guanglun/openvio_board/Doc/OPENVIO_V1.6_SCH.pdf

C0402 ¹ 2 | FB1 | 100MHz 180R

# SPI3_SSEL SPI3_MISO

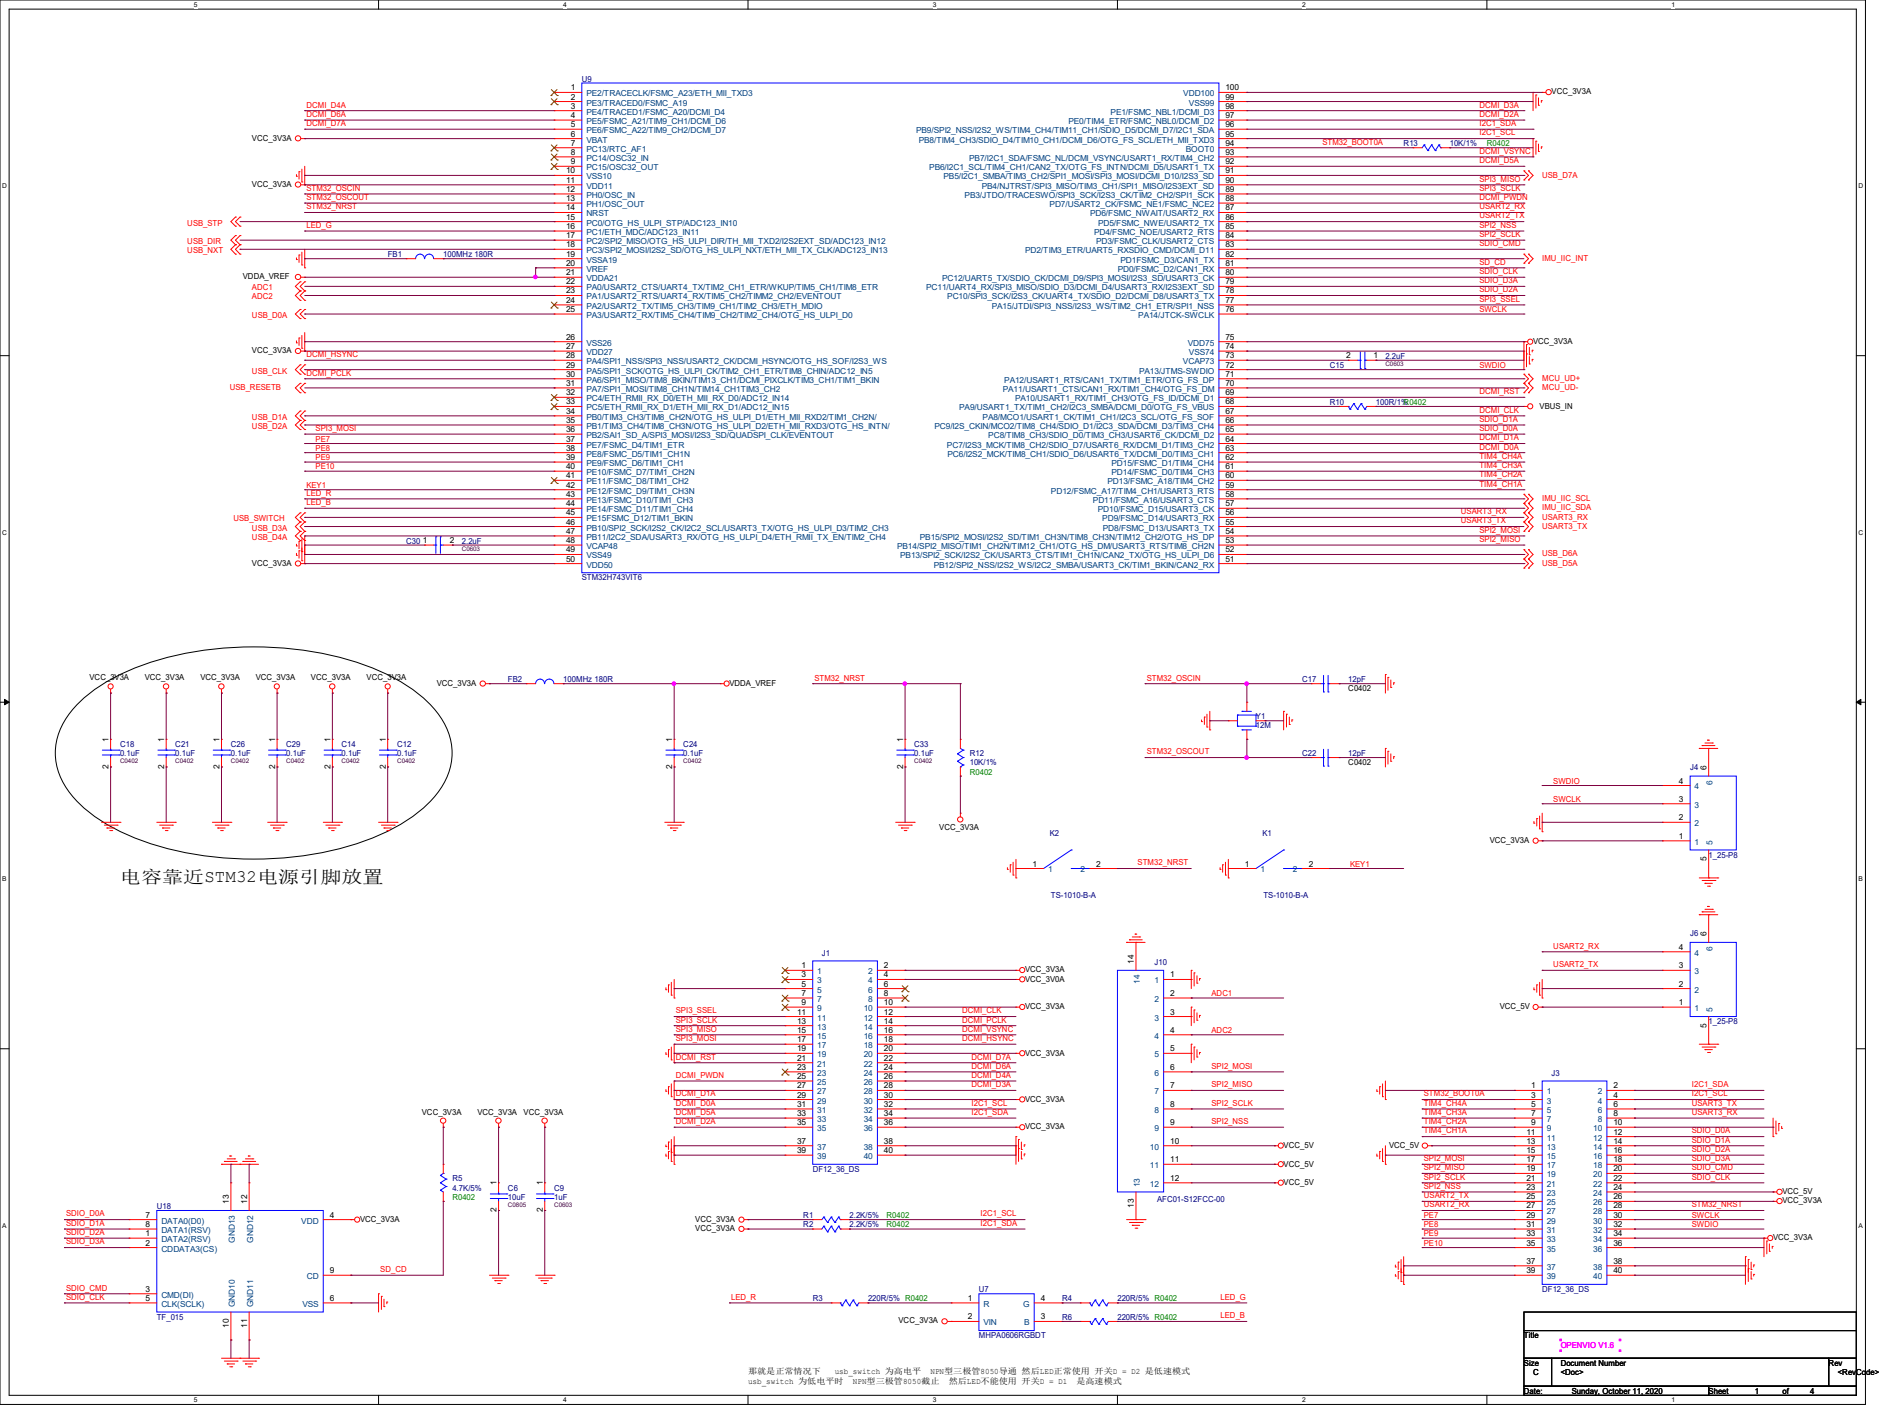
[picture p1: page 1]

A A usb_switch 为低电平时 NPN型三极管8050截止 然后LED不能使用 开关D = D1 是高速模式

供电3V3给MCU | 供电3V3给IMU

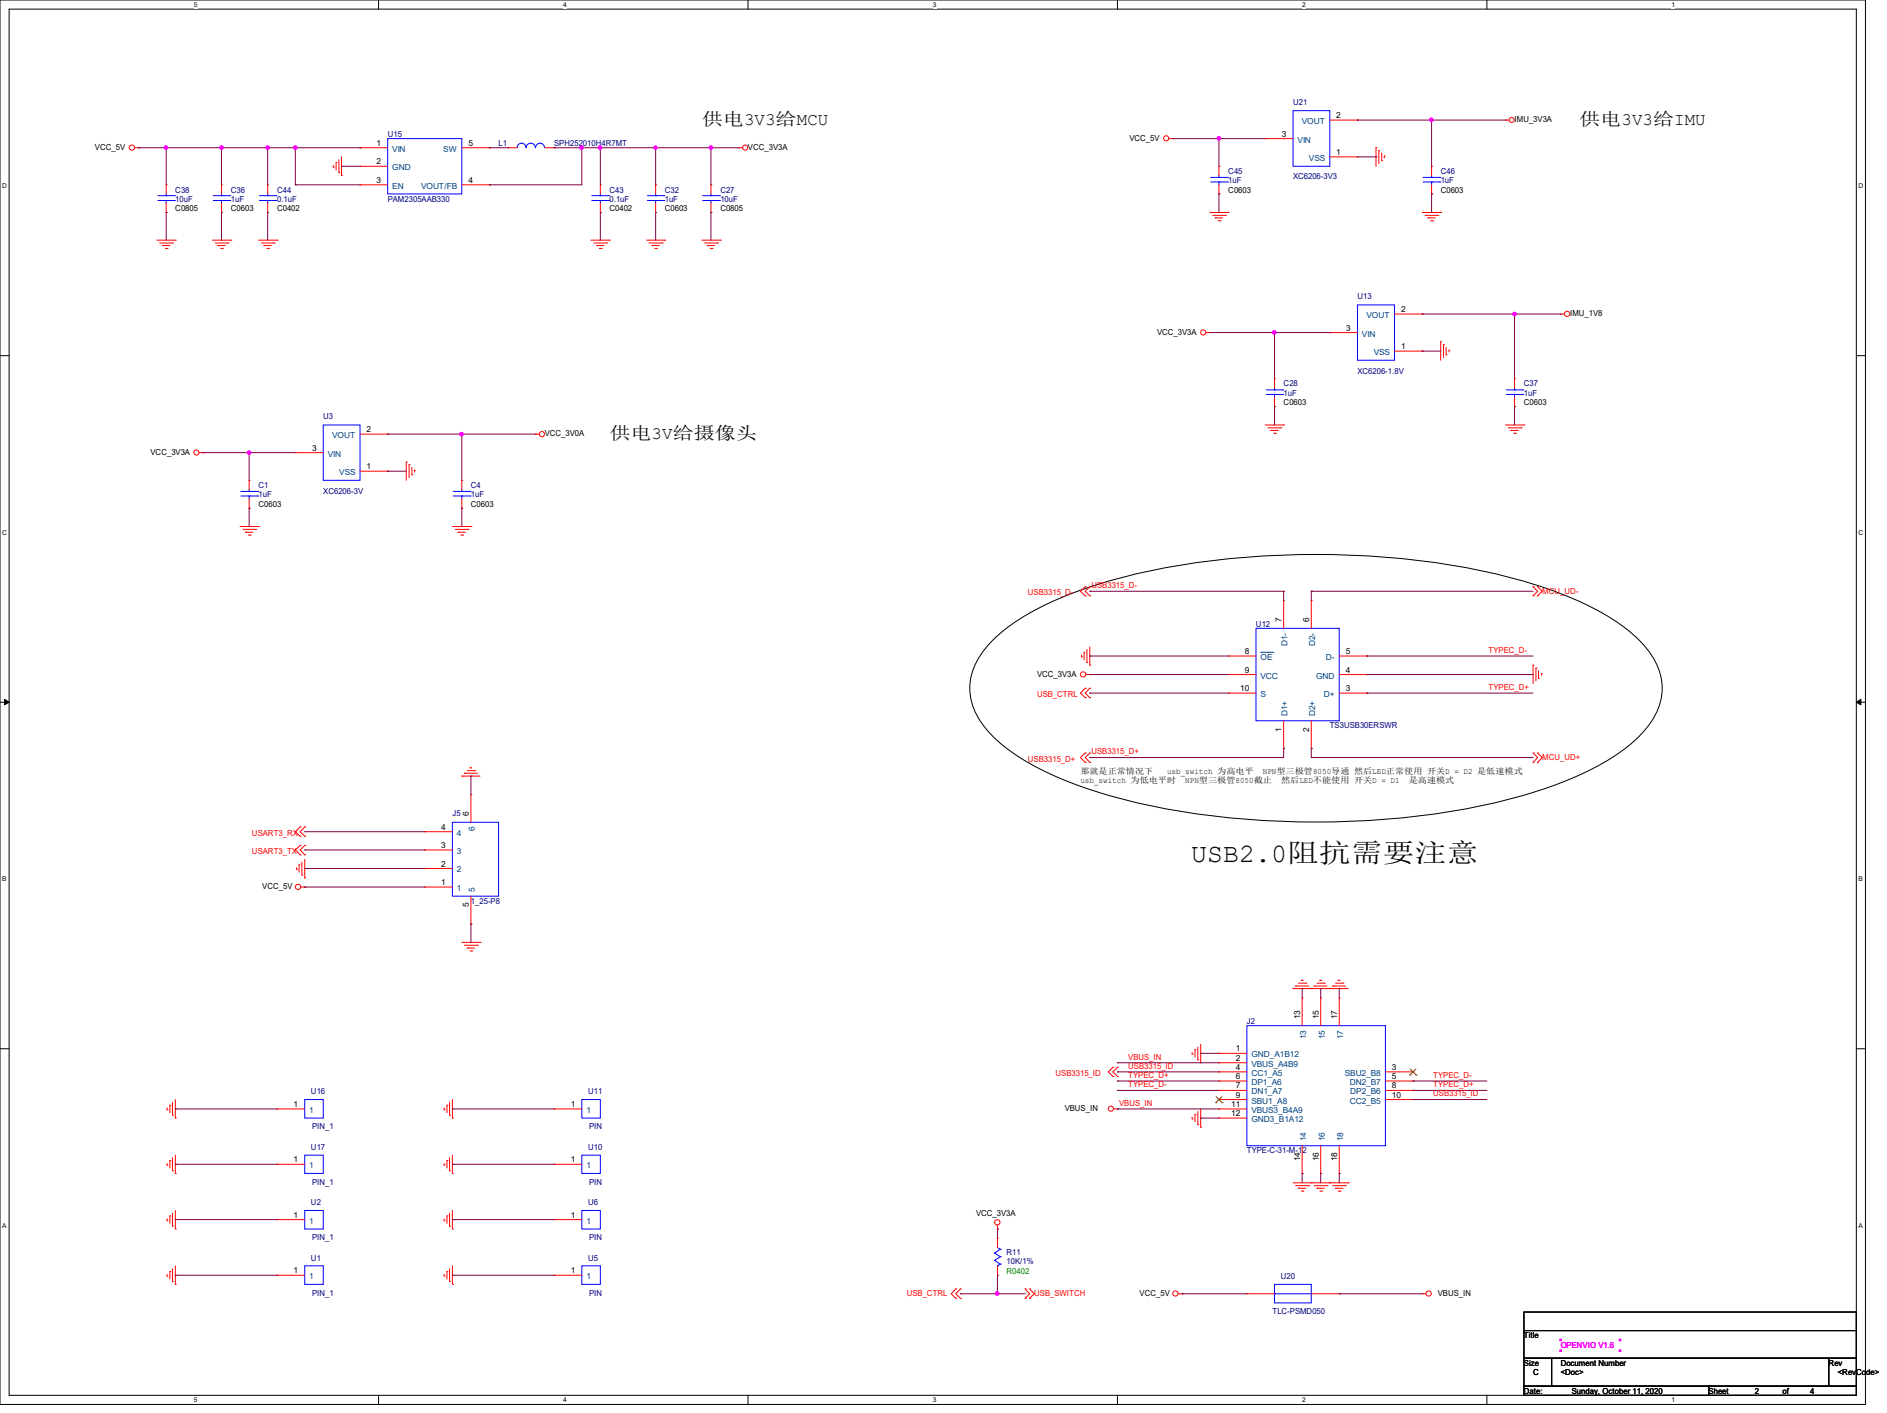
[picture p2: page 2]

usb_switch 为低电平时 NPN型三极管8050截止 然后LED不能使用 开关D = D1 是高速模式

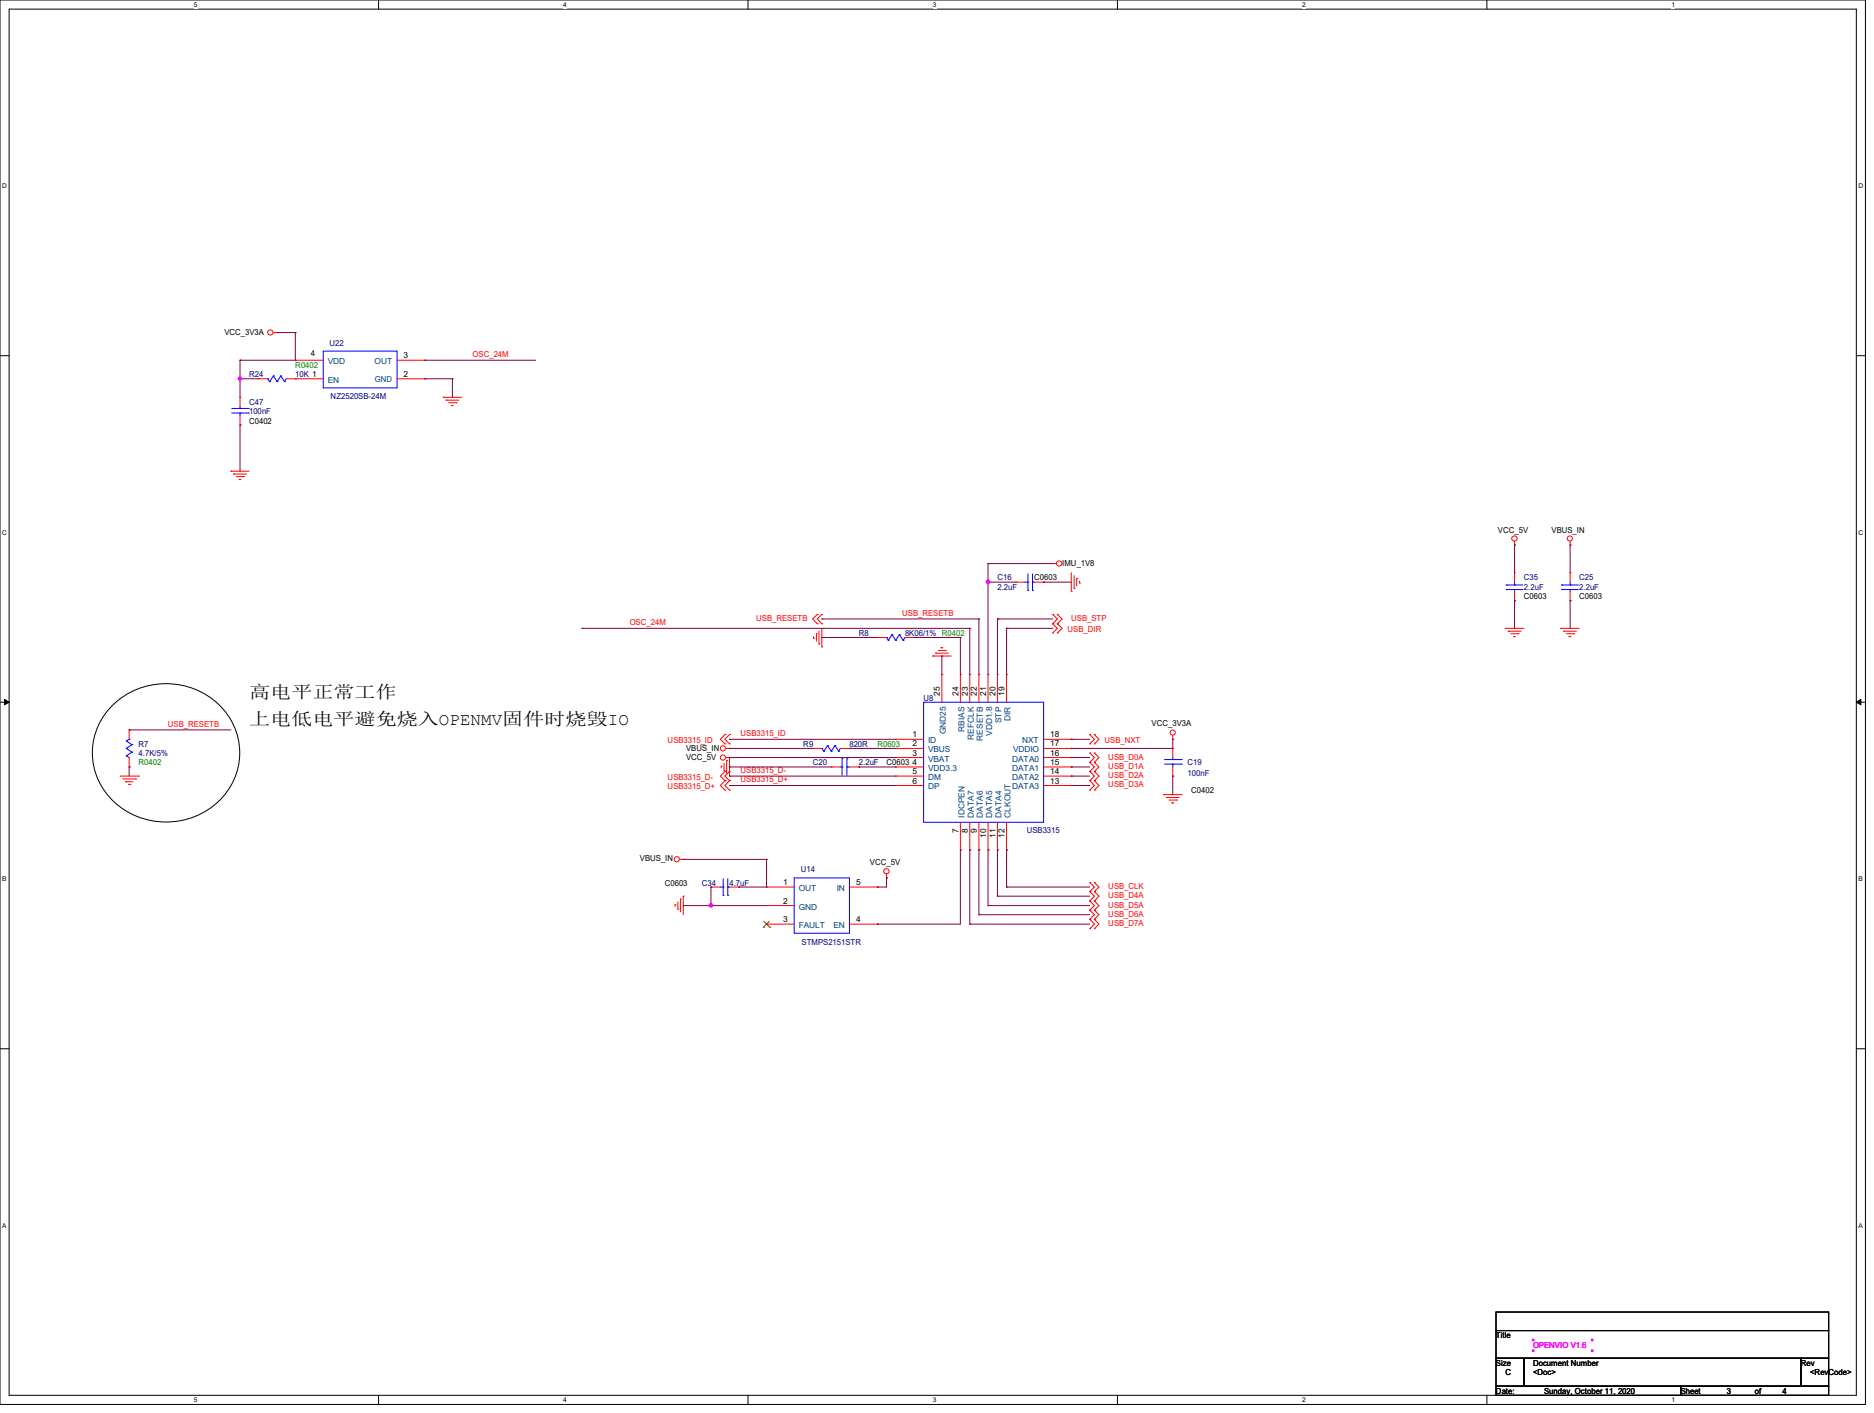
[picture p3: page 3]

9 DATA5 10 DATA4 11 CLKOUT 12 DATA3 13 DATA2 14 DATA1 15 DATA0 16 VDDIO 17 NXT 18 DIR 19 STP 20 VDD1.8 21 RESETB 22 REFCLK 23 RBIAS 24 GND25 25 C16

## IMU_3V3A

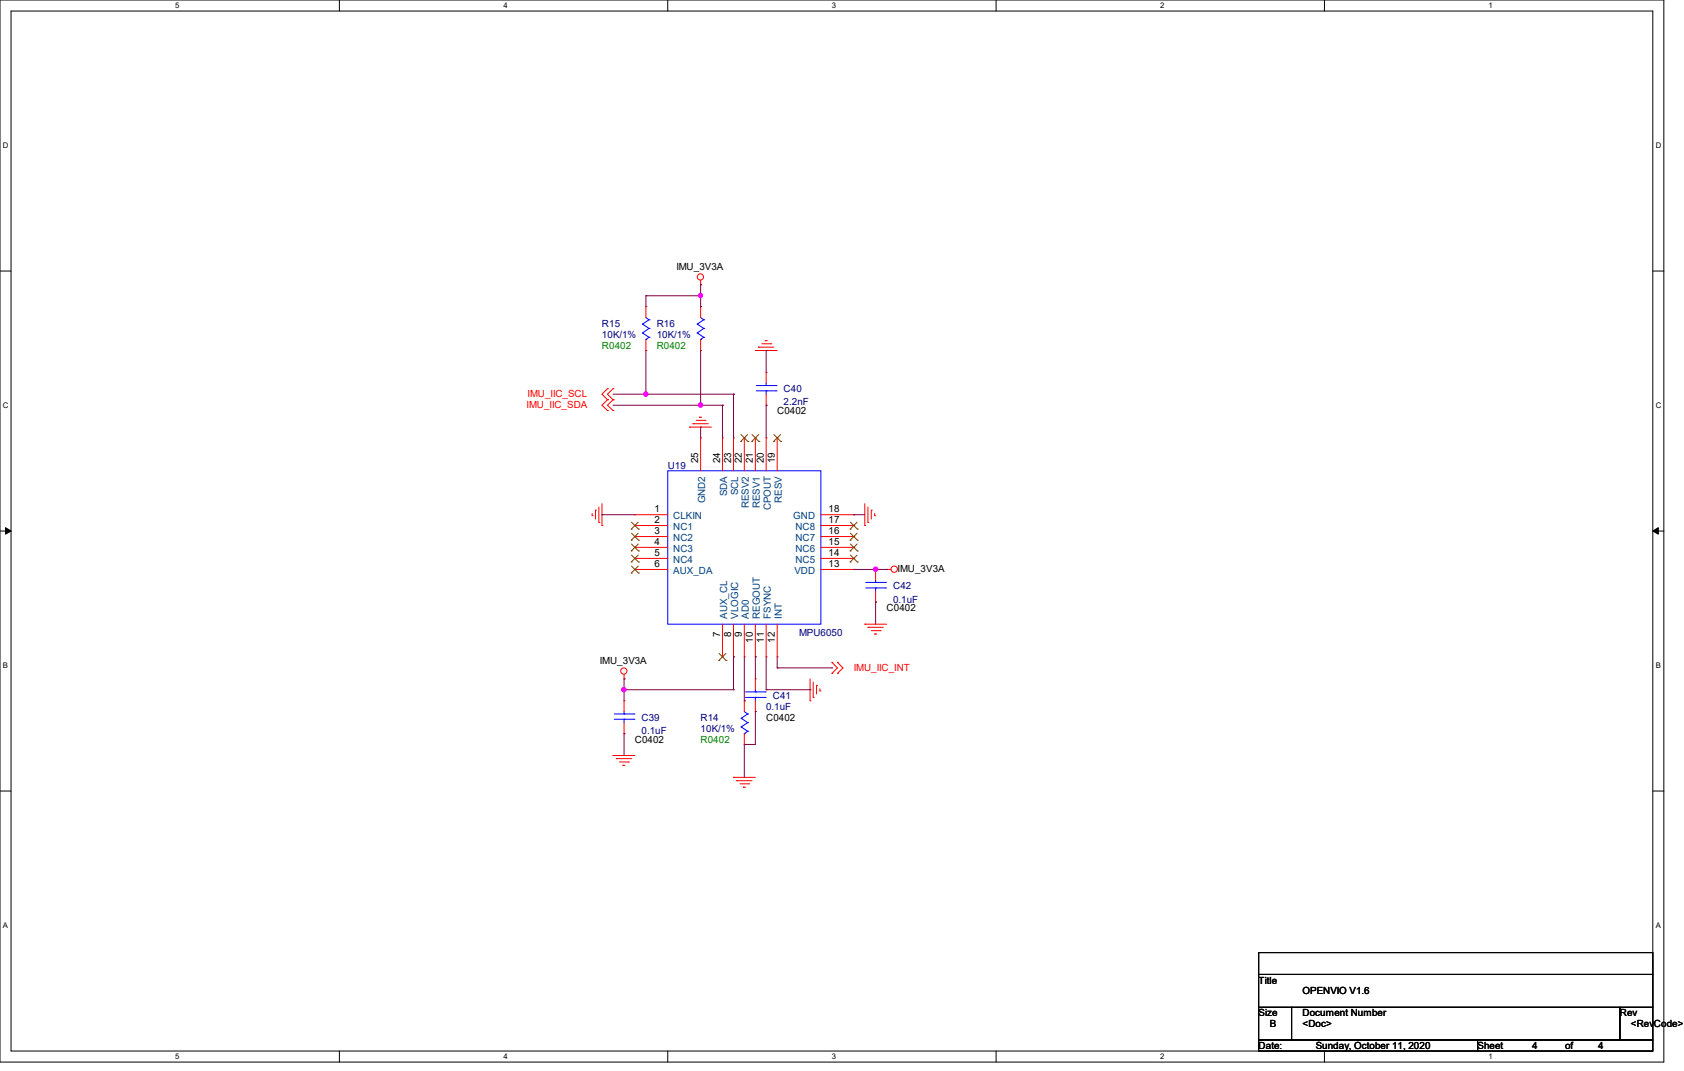
[picture p4: page 4]

9 REGOUT 10 FSYNC 11 INT 12 VDD 13 NC5 14 NC6 15 NC7 16 NC8 17 GND 18 RESV 19 CPOUT 20 RESV1 21 RESV2 22 SCL 23 SDA 24 GND2 25 C42
