guanglun/openvio_board/Src/main.c

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

/* Includes ------------------------------------------------------------------*/
#include "main.h"
#include "cmsis_os.h"
#include "adc.h"
#include "dcmi.h"
#include "dma.h"
#include "fatfs.h"
#include "i2c.h"
#include "mdma.h"
#include "sdmmc.h"
#include "spi.h"
#include "tim.h"
#include "usart.h"
#include "usb_device.h"
#include "gpio.h"


void SystemClock_Config(void);
void MX_FREERTOS_Init(void);
/* USER CODE BEGIN PFP */
uint32_t timer_cnt = 0;
/* USER CODE END PFP */

/**
  * @brief  The application entry point.
  * @retval int
  */
int main(void)
{
  /* Enable I-Cache---------------------------------------------------------*/
  SCB_EnableICache();

  /* MCU Configuration--------------------------------------------------------*/

  /* Reset of all peripherals, Initializes the Flash interface and the Systick. */
  HAL_Init();

  /* Configure the system clock */
  SystemClock_Config();

  /* USER CODE BEGIN SysInit */
  __HAL_RCC_DMA2_CLK_ENABLE();//must enable dma2,for dcmi work well.
  /* USER CODE END SysInit */

  /* Initialize all configured peripherals */
  MX_GPIO_Init();
  MX_DCMI_Init();
  MX_I2C1_Init();
  MX_DMA_Init();
  MX_SDMMC1_SD_Init();
  MX_FATFS_Init();
  MX_SPI2_Init();
  MX_MDMA_Init();
  MX_ADC1_Init();
  MX_USART2_UART_Init();
  MX_TIM6_Init();
  MX_TIM13_Init();
  /* USER CODE BEGIN 2 */
  HAL_TIM_Base_Start_IT(&htim6);
  HAL_TIM_Base_Start_IT(&htim13);
  printf("hello openvio\r\n");

  /* USER CODE END 2 */

  /* Call init function for freertos objects (in freertos.c) */
  MX_FREERTOS_Init(); 
  /* Start scheduler */
  osKernelStart();
 
  /* We should never get here as control is now taken by the scheduler */
  /* Infinite loop */
  /* USER CODE BEGIN WHILE */
  while (1)
  {
    /* USER CODE END WHILE */

    /* USER CODE BEGIN 3 */
      //CDC_Transmit_HS(send_buf,sizeof(send_buf));
  }
  /* USER CODE END 3 */
}

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
/* USER CODE BEGIN 4 */
void get_time(uint32_t *t1_cnt,uint16_t *t2_cnt)
{
	*t2_cnt = htim6.Instance->CNT;
	*t1_cnt = timer_cnt;
}
/* USER CODE END 4 */

 /**
  * @brief  Period elapsed callback in non blocking mode
  * @note   This function is called  when TIM7 interrupt took place, inside
  * HAL_TIM_IRQHandler(). It makes a direct call to HAL_IncTick() to increment
  * a global variable "uwTick" used as application time base.
  * @param  htim : TIM handle
  * @retval None
  */
void HAL_TIM_PeriodElapsedCallback(TIM_HandleTypeDef *htim)
{
  if (htim->Instance == TIM7) {
    HAL_IncTick();
  }
  /* USER CODE BEGIN Callback 1 */
  if (htim->Instance == TIM6) {
	timer_cnt++;
    //HAL_GPIO_TogglePin(TEST1_GPIO_Port, TEST1_Pin);
  }  
  
  if (htim->Instance == TIM13) {
	  //HAL_GPIO_WritePin(TEST1_GPIO_Port, TEST1_Pin, GPIO_PIN_SET);

	  //mpu6050_transmit();

	  //HAL_GPIO_WritePin(TEST1_GPIO_Port, TEST1_Pin, GPIO_PIN_RESET);
	  
	//icm20948_transmit();
    //HAL_GPIO_TogglePin(TEST1_GPIO_Port, TEST1_Pin);
  }  
  /* USER CODE END Callback 1 */
}

/**
  * @brief  This function is executed in case of error occurrence.
  * @retval None
  */
void Error_Handler(void)
{
  /* USER CODE BEGIN Error_Handler_Debug */
  /* User can add his own implementation to report the HAL error return state */

  /* USER CODE END Error_Handler_Debug */
}

#ifdef  USE_FULL_ASSERT
/**
  * @brief  Reports the name of the source file and the source line number
  *         where the assert_param error has occurred.
  * @param  file: pointer to the source file name
  * @param  line: assert_param error line source number
  * @retval None
  */
void assert_failed(uint8_t *file, uint32_t line)
{ 
  /* USER CODE BEGIN 6 */
  /* User can add his own implementation to report the file name and line number,
     tex: printf("Wrong parameters value: file %s on line %d\r\n", file, line) */
  /* USER CODE END 6 */
}
#endif /* USE_FULL_ASSERT */

/************************ (C) COPYRIGHT STMicroelectronics *****END OF FILE****/
