guanglun/openvio_board/STM32H7VIO.ioc

Mcu.UserName=STM32H743VITx
PA0.Signal=ADC1_INP16
PA1.Signal=ADC1_INP17
PA10.GPIO_Label=DCMI_RST
PA10.Signal=GPIO_Output
PA3.Signal=USB_OTG_HS_ULPI_D0
PA4.Signal=DCMI_HSYNC
PA5.Signal=USB_OTG_HS_ULPI_CK
PA6.Signal=DCMI_PIXCLK
PA7.GPIO_Label=USB_ENABLE
PA7.Signal=GPIO_Output
PA8.Signal=RCC_MCO_1
PB0.Signal=USB_OTG_HS_ULPI_D1
PB1.Signal=USB_OTG_HS_ULPI_D2
PB10.Signal=USB_OTG_HS_ULPI_D3
PB11.Signal=USB_OTG_HS_ULPI_D4
PB12.Signal=USB_OTG_HS_ULPI_D5
PB13.Signal=USB_OTG_HS_ULPI_D6
PB14.Signal=SPI2_MISO
PB15.Signal=SPI2_MOSI
PB5.Signal=USB_OTG_HS_ULPI_D7
PB6.Signal=DCMI_D5
PB7.Signal=DCMI_VSYNC
PB8.Signal=I2C1_SCL
PB9.Signal=I2C1_SDA
PC0.Signal=USB_OTG_HS_ULPI_STP
PC1.GPIO_Label=LED_G
PC1.Signal=GPIO_Output
PC10.Signal=SDMMC1_D2
PC11.Signal=SDMMC1_D3
PC12.Signal=SDMMC1_CK
PC2_C.Signal=USB_OTG_HS_ULPI_DIR
PC3_C.Signal=USB_OTG_HS_ULPI_NXT
PC4.GPIO_Label=IMU_INT
PC4.Signal=GPXTI4
PC5.GPIO_Label=IMU_FSYNC
PC5.Signal=GPIO_Output
PC6.Signal=DCMI_D0
PC7.Signal=DCMI_D1
PC8.Signal=SDMMC1_D0
PC9.Signal=SDMMC1_D1
PD0.GPIO_Label=SD_CD
PD0.Signal=GPIO_Input
PD1.GPIO_Label=IMU_SPI_CS
PD1.Signal=GPIO_Output
PD10.GPIO_Label=IMU_SDA
PD10.Signal=GPIO_Output
PD11.GPIO_Label=IMU_SCL
PD11.Signal=GPIO_Output
PD2.Signal=SDMMC1_CMD
PD3.Signal=SPI2_SCK
PD4.GPIO_Label=TFT_SPI_CS
PD4.Signal=GPIO_Output
PD5.Signal=USART2_TX
PD6.Signal=USART2_RX
PD7.GPIO_Label=DCMI_PWDN
PD7.Signal=GPIO_Output
PD8.GPIO_Label=TEST1
PD8.Signal=GPIO_Output
PD9.GPIO_Label=TEST2
PD9.Signal=GPIO_Output
PE0.Signal=DCMI_D2
PE1.Signal=DCMI_D3
PE10.GPIO_Label=LED_E10
PE10.Signal=GPIO_Output
PE12.GPIO_Label=KEY
PE12.Signal=GPIO_Input
PE13.GPIO_Label=LED_R
PE13.Signal=GPIO_Output
PE14.GPIO_Label=LED_B
PE14.Signal=GPIO_Output
PE15.GPIO_Label=USB_SWITCH
PE15.Signal=GPIO_Output
PE4.Signal=DCMI_D4
PE5.Signal=DCMI_D6
PE6.Signal=DCMI_D7
PE7.GPIO_Label=INPUT_E7
PE7.Signal=GPIO_Input
PE8.GPIO_Label=INPUT_E8
PE8.Signal=GPIO_Input
PE9.GPIO_Label=LED_E9
PE9.Signal=GPIO_Output
