guanglun/openvio_board/Src/usart.c

/**
  ******************************************************************************
  * File Name          : USART.c
  * Description        : This file provides code for the configuration
  *                      of the USART instances.
  ******************************************************************************
  * @attention
  *
  * <h2><center>&copy; Copyright (c) 2023 STMicroelectronics.
  * All rights reserved.</center></h2>
  *
  * This software component is licensed by ST under Ultimate Liberty license
  * SLA0044, the "License"; You may not use this file except in compliance with
  * the License. You may obtain a copy of the License at:
  *                             www.st.com/SLA0044
  *
  ******************************************************************************
  */

/* Includes ------------------------------------------------------------------*/
#include "usart.h"

/* USER CODE BEGIN 0 */
#include "stdio.h"

struct __FILE
{	
	int handle; 
};
FILE __stdout; 
  
void _sys_exit(int x)
{		
	x = x;
}

int fputc(int ch, FILE *f)
{
	HAL_UART_Transmit(&huart2, (uint8_t *)&ch, 1, 0xFFFF);	
	return ch;
}
/* USER CODE END 0 */

UART_HandleTypeDef huart2;

/* USART2 init function */

void MX_USART2_UART_Init(void)
{

  huart2.Instance = USART2;
  huart2.Init.BaudRate = 115200;
  huart2.Init.WordLength = UART_WORDLENGTH_8B;
  huart2.Init.StopBits = UART_STOPBITS_1;
  huart2.Init.Parity = UART_PARITY_NONE;
  huart2.Init.Mode = UART_MODE_TX_RX;
  huart2.Init.HwFlowCtl = UART_HWCONTROL_NONE;
  huart2.Init.OverSampling = UART_OVERSAMPLING_16;
  huart2.Init.OneBitSampling = UART_ONE_BIT_SAMPLE_DISABLE;
  huart2.Init.ClockPrescaler = UART_PRESCALER_DIV1;
  huart2.AdvancedInit.AdvFeatureInit = UART_ADVFEATURE_NO_INIT;
  if (HAL_UART_Init(&huart2) != HAL_OK)
  {
    Error_Handler();
  }
  if (HAL_UARTEx_SetTxFifoThreshold(&huart2, UART_TXFIFO_THRESHOLD_1_8) != HAL_OK)
  {
    Error_Handler();
  }
  if (HAL_UARTEx_SetRxFifoThreshold(&huart2, UART_RXFIFO_THRESHOLD_1_8) != HAL_OK)
  {
    Error_Handler();
  }
  if (HAL_UARTEx_DisableFifoMode(&huart2) != HAL_OK)
  {
    Error_Handler();
  }

}

void HAL_UART_MspInit(UART_HandleTypeDef* uartHandle)
{

  GPIO_InitTypeDef GPIO_InitStruct = {0};
  if(uartHandle->Instance==USART2)
  {
    /* USART2 clock enable */
    __HAL_RCC_USART2_CLK_ENABLE();
  
    __HAL_RCC_GPIOD_CLK_ENABLE();
    /**USART2 GPIO Configuration    
    PD5     ------> USART2_TX
    PD6     ------> USART2_RX 
    */
    GPIO_InitStruct.Pin = GPIO_PIN_5|GPIO_PIN_6;
    GPIO_InitStruct.Mode = GPIO_MODE_AF_PP;
    GPIO_InitStruct.Pull = GPIO_NOPULL;
    GPIO_InitStruct.Speed = GPIO_SPEED_FREQ_LOW;
    GPIO_InitStruct.Alternate = GPIO_AF7_USART2;
    HAL_GPIO_Init(GPIOD, &GPIO_InitStruct);

  }
}

void HAL_UART_MspDeInit(UART_HandleTypeDef* uartHandle)
{

  if(uartHandle->Instance==USART2)
  {
    /* Peripheral clock disable */
    __HAL_RCC_USART2_CLK_DISABLE();
  
    /**USART2 GPIO Configuration    
    PD5     ------> USART2_TX
    PD6     ------> USART2_RX 
    */
    HAL_GPIO_DeInit(GPIOD, GPIO_PIN_5|GPIO_PIN_6);

  }
} 

/* USER CODE BEGIN 1 */
extern uint8_t rx_buffer[20];
//void HAL_UART_RxCpltCallback(UART_HandleTypeDef *huart)
//{
//  /* Prevent unused argument(s) compilation warning */
//  
//  /* NOTE : This function should not be modified, when the callback is needed,
//            the HAL_UART_RxCpltCallback can be implemented in the user file
//   */
//      HAL_UART_Transmit(&huart2, (uint8_t *)rx_buffer, 1,0xFFFF);
//      HAL_UART_Receive_IT(&huart2, (uint8_t *)rx_buffer, 1);
//}
/* USER CODE END 1 */

/************************ (C) COPYRIGHT STMicroelectronics *****END OF FILE****/
