guanglun/openvio_board/(commit log)

2019-12-04 正在进行mt9v034驱动
2019-12-06 mt9v034仍未调试OK
2019-12-08 摄像头仍未调试完毕
2019-12-09 wocaowocao 终于见到曙光了！buffer数据终于改变了我去！赶紧上传一下！
2019-12-09 正在usb与摄像头协调
2019-12-11 测试图像
2019-12-12 只小分辨率OK，肯定有哪里不对！
2019-12-14 使用内部USB FS调试640x480成功
2019-12-14 HS传输摄像头数据成功
2019-12-15 正在调试HS 暂时上传
2019-12-17 HS 调试
2019-12-18 MPU6000读取到ID
2019-12-20 添加未经验证的SD卡程序
2019-12-21 初步在CDC基础上实现WINUSB，参考MichaelTien8901/STM32WINUSB
2019-12-23 双IN bulk完成，调试MPU6000中
2019-12-24 MPU6000读出数据
2019-12-24 cubemx操作前提交一下
2019-12-24 增加IMU功能，功能架构待优化
2019-12-25 优化传输逻辑，后续肯定还需优化
2019-12-26 修改分辨率为752x480
2020-01-20 不适用MPU6000
2020-01-20 icm20948正确去读到了ID
2020-01-20 USB3315使用内部TIM生成时钟24M时钟完成，ICM20948的SPI频率使用6.25MHz
2020-01-20 正在调试ICM20948
2020-01-22 测试sd卡
2020-02-15 加速度椭球拟合
2020-02-26 update IMU数据上传
2020-02-28 摄像头图像对称调试
2020-03-10 同步时间优化
2020-03-11 校准数据修改
2020-03-13 SD卡问题调试了两天，最终发现和SD卡质量有很大关系，同时程序的配置也会有影响，配置有问题会损坏
2020-03-22 为降温，将主频从480降至384
2020-03-29 暂时解决图像传输同步问题
2020-04-03 LED open
2020-04-03 adc and key update
2020-04-05 优化USB传输
2020-04-05 暂存 传输有问题 需要看旧代码
2020-04-05 分辨率设置初步完成
2020-04-11 正在调试ov7725
2020-04-11 摄像头时钟调整27Mhz
2020-04-11 准备调试分行传输
2020-04-13 ADC调试初步OK
2020-04-13 大屏显示摄像头数据初步完成
2020-04-13 正在调试屏幕显示
2020-04-14 准备调试
2020-04-15 摄像头时钟江降速 调试OV7725中（还未成功）
2020-04-16 摄像头初步调试OK
2020-04-16 IMU的200Hz中断不是很理想 需要尝试使用USB的中断传输
2020-04-16 修改初始camera时钟
2020-04-20 调试TIM1
2020-04-20 接下来加入时间戳
2020-04-20 IMU数据传输存在问题 明天继续调试
2020-04-21 IMU在开启摄像头时数据有误问题通过硬件更改电容解决，各项测试目前OK
2020-04-21 IMU校准输出
2020-04-22 磁力计数据读取
2020-06-02 调试IMU暂存
2020-06-02 MT9V034和OV7725初步OK
2020-06-03 增加CAM时间戳
2020-08-02 update LCD上位机同步显示 还未调试OK
2020-08-03 准备优化一下代码 准备发布
2020-08-03 消除报错
2020-11-17 update 加入MT9V034曝光设置
2023-12-27 update 连续传输
