guanglun/openvio_board/(notices)

Notices in the files:
Src/main.c:
© Copyright (c) 2019 STMicroelectronics.
All rights reserved.
